ZeroMips/PetroLED/SSSS811101.step

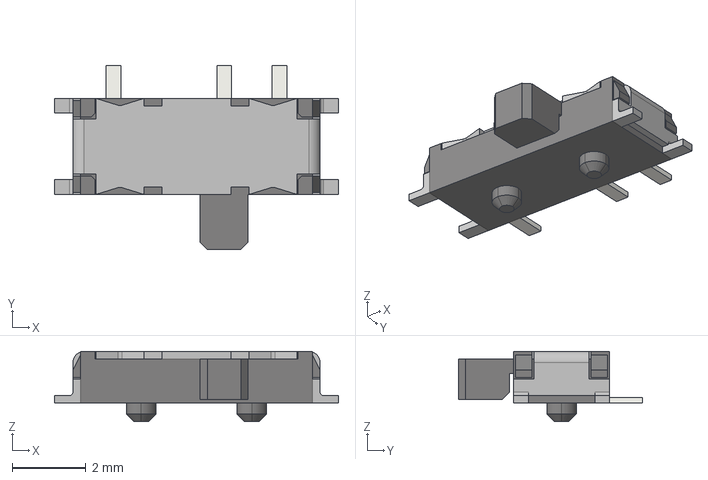
[picture p3: CAD file, 2024-04-05]
SSSS811101.step
7.70 x 5.00 x 1.90 mm
