ZeroMips/PetroLED/1021.step

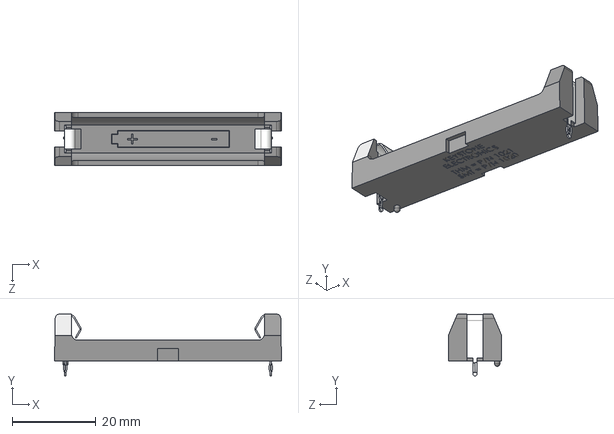
[picture p4: CAD file, 2024-04-05]
1021.step
54.1 x 14.7 x 12.7 mm
