ZeroMips/PetroLED/simulation/filament.asc

C1: cap; 100n
C2: cap; 10p
D1: diode; 1N4148
L1: ind; 100µ; Ipk=1 Rser=0.4 Rpar=76361.7 Cpar=0 mfg="Bourns, Inc." pn="SRN8040-101M"
Q1: npn; MMBTA06
Q2: npn; MMBTA06
R1: res; 1k
R2: res; 100k
R3: res; 19.85k
R4: res; 5.73k
R5: res; 3.56k
R6: res; 2.92k
R7: res; 2.46k
R8: res; 1.61k
S1: sw; FILAMENTSW
S2: sw; FILAMENTSW
S3: sw; FILAMENTSW
S4: sw; FILAMENTSW
S5: sw; FILAMENTSW
S6: sw; FILAMENTSW
V1: voltage; 1.5
V2: voltage; 62
V3: voltage; 64.6
V4: voltage; 65.81
V5: voltage; 67.01
V6: voltage; 68
V7: voltage; 70
Named nets: 0, OUT
.tran 0 100ms 0 startup
.model FILAMENTSW SW(Ron=1 Roff=10Meg Vt=10u)
.lib D:\\Kicad\\filament\\simulation\\MMBT5551.spice.txt
.lib D:\\Kicad\\filament\\simulation\\MPSA06.LIB
.lib D:\\Kicad\\filament\\MMBTA06.spice.txt
