ZeroMips/PetroLED/simulation/filament_part.asc

D1: diode; filament
G2: g2; table = (0 0, 62 0, 64.6 0.131, 65.81 0.403, 67.01 1.01, 68 1.85, 70 4.36 73.1 10.18)
V7: voltage; ""
Named nets: 0
.dc V7 50 75 0.1
.model FILAMENTSW SW(Ron=1 Roff=10Meg Vt=10u)
.model filament D =(IS=1e-28, N=40, RS=0.4)
