ZeroMips/PetroLED/filament.kicad_pcb

## KiCad design filament.kicad_pcb (2024-04-05)

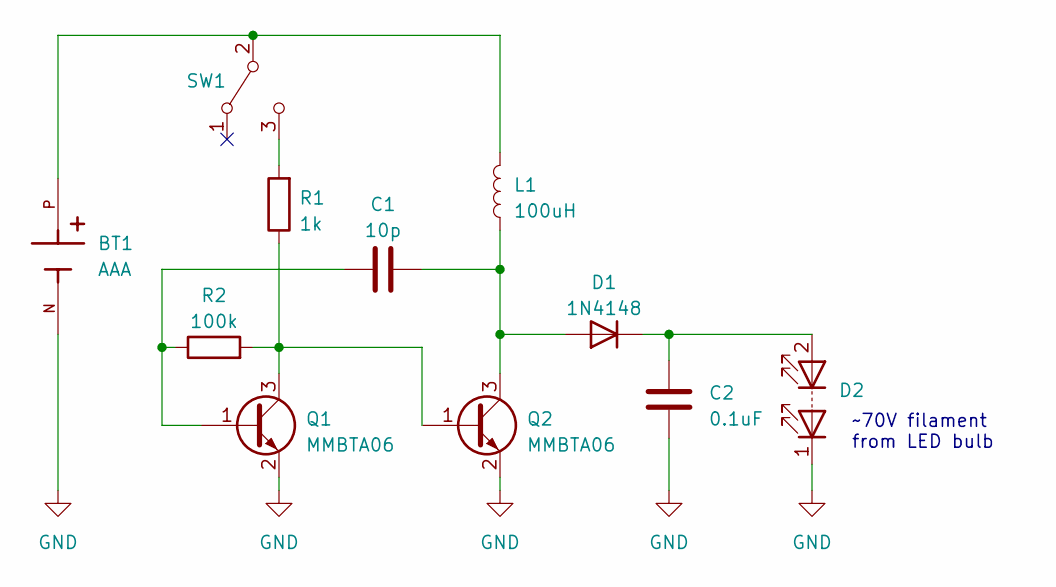
[picture p5: schematic filament.kicad_sch]

Parts:
BT1: AAA; BAT_1021; PARTREV A
C1: 10p; C_0603_1608Metric; LCSC C1634
C2: 0.1uF; C_0805_2012Metric; Voltage 100V; LCSC C28233
D1: 1N4148; D_SOD-123; LCSC C81598
D2: LED_Series; Filament
L1: 100uH; L_Bourns-SRN8040_8x8.15mm; LCSC C5127433
Q1, Q2: MMBTA06; SOT-23; LCSC C713285
R1: 1k; R_0805_2012Metric; LCSC C17513
R2: 100k; R_0805_2012Metric; LCSC C149504
SW1: SW_SPST; SSSS811101; LCSC C109335

Connections:
GND: BT1.N, C2.2, D2.1 (K), Q1.2 (E), Q2.2 (E)
unnamed: C1.2, D1.2 (A), L1.1, Q2.3 (C)
unnamed: C2.1, D1.1 (K), D2.2 (A)
unnamed: C1.1, Q1.1 (B), R2.1
unnamed: Q1.3 (C), Q2.1 (B), R1.1, R2.2
unnamed: BT1.P, L1.2, SW1.2 (B)
unnamed: R1.2, SW1.3 (C)

Notes on the sheet:
~70V filament from LED bulb

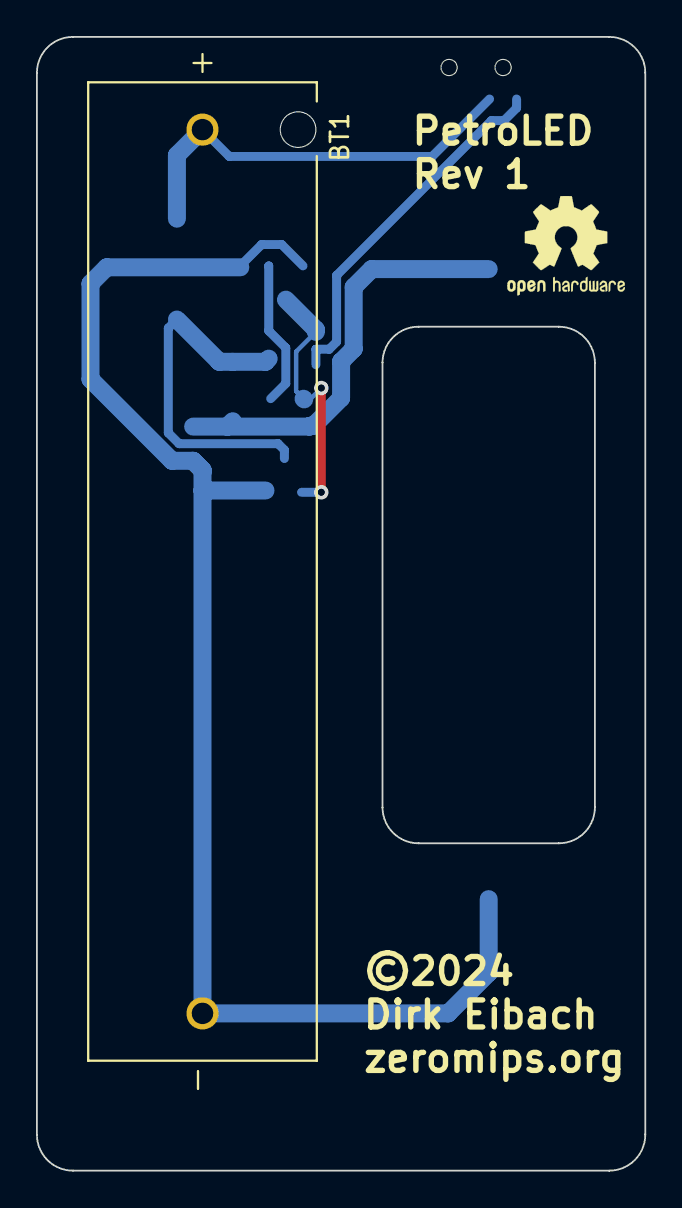
[picture p6: board filament.kicad_pcb from above]

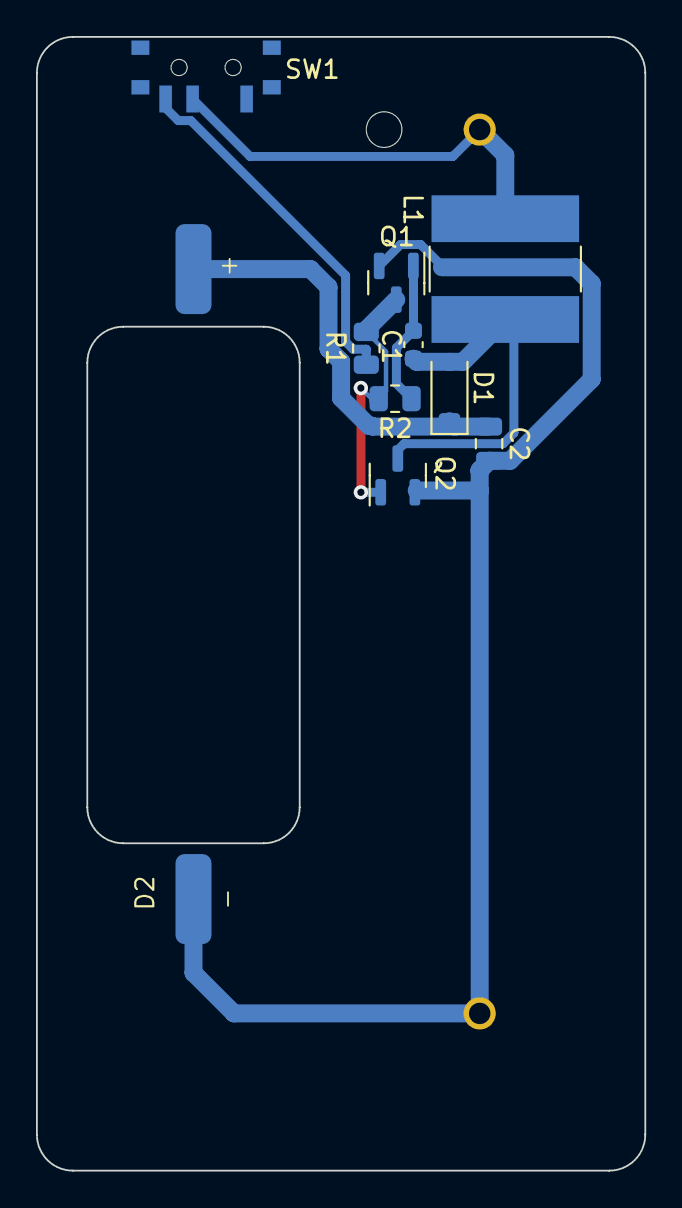
[picture p7: board filament.kicad_pcb from below]

Board: 2 copper layers, 33.8 x 63.0 mm, 11 parts (10 on the bottom side), 7 nets.
