ZeroMips/PetroLED/(notices)

Notices in the files:
filament.kicad_pcb:
©2024
